JaoDekeyser/Linefollower/readme.md

# LineFollower

Voor iedereen die een RC auto'tje wilt dat je niet hoeft/kan besturen.

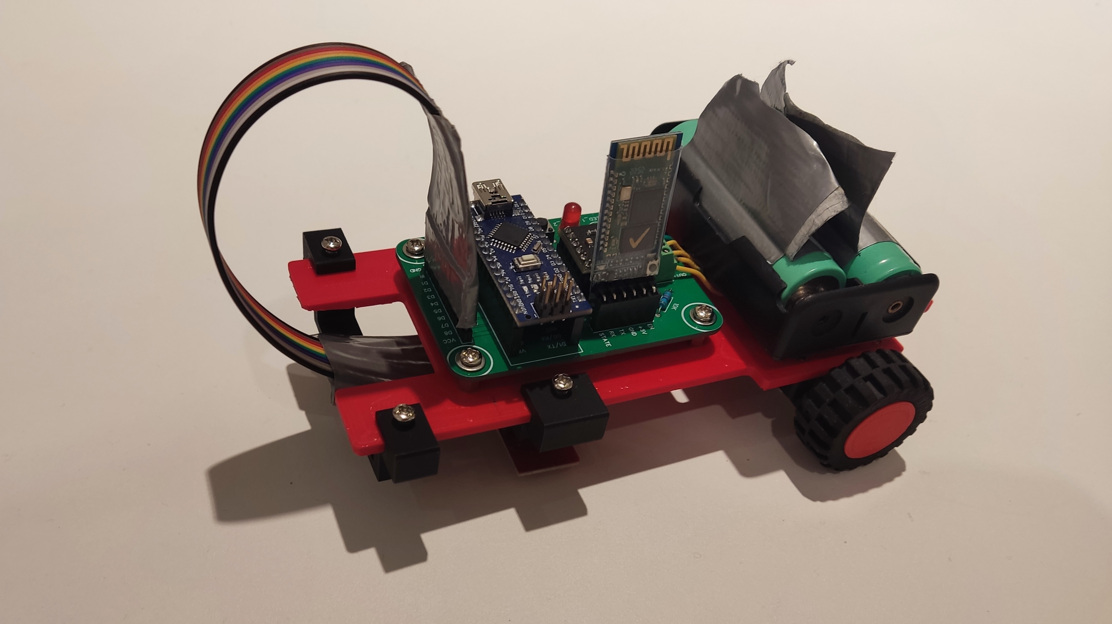
[picture p1: images/Line_Follow_Robot.jpg]
Line follow robot Syntheseproject Jao


## specifications

microcontroller: Arduino Nano Every ATMEGA4809 AVR

motors: 6V Pololu micro metal gearmotors with gear ratio30:1

h-bridge: DRV8833 Dual H-Bridge Motor Drive

sensors: QTR-8A Reflectance Sensor

batteries: 18650 Li-ion

wireless communication: HC-05 -Bluetooth to Serial Port Module

distance sensor - motors: +-8cm

weight: 283g

speed: 0.6 m/s
