JaoDekeyser/Linefollower/code/proof of concepts/wireless communication/readme.md

# draadloze communicatie proof of concept
minimale hard- en software waarmee aangetoond wordt dat duplex kan gecommuniceerd worden tussen de microcontroller en een smartphone, gebruik makend van Serial Bluetooth terminal
<br />
### configuratie
HC05-Bluetooth to Serial Port Module
### opmerkingen
PC arduino serial monitor & smartphone nodig
### gebruiksaanwijzing
Aangeraden smartphone APP: Serial Bluetooth Terminal
