JaoDekeyser/Linefollower/bill of materials/readme.md

## bill of materials
<br />

|volgnummer|naam|omschrijving|nieuw/recup|kostprijs/stuk|aantal|subtotaal|
|---|----|---|---|---|---|---|
| 1| Microcontroller |  Arduino Nano Every ATMEGA4809 AVR |nieuw| 14.96€ | 1 | 14.96€ |
| 2| Sensor |  QTR-8A Reflectance Sensor Array  |nieuw| 1.24€ | 1 | 1.24€ |
| 3| H-brug |  DRV8833 Dual H-Bridge Motor Drive  |nieuw| 0.48€ | 1 | 0.48€ |
| 4| Motor |  Gear motor 6V 50:1 (GA12-N20 --> chinees)  |nieuw| 1.75€ | 2 | 3.50€ |
| 5| Bluetooth module |  HC-05 -Bluetooth to Serial Port Module  |nieuw| 3.47€ | 1 | 3.90€ |
| 6| Batterij |  18650 Li-ion  |nieuw| 2.51€ | 2 | 5.02€ |
| 7| Batterij-houder |  18650 batterij-houder  |nieuw| 1.64€ | 1 | 1.64€ |
| 8| Batterij-lader |  18650 batterij-lader  |nieuw| 3.69€ | 1 | 3.69€ |
| 9| Weerstand 220Ω |  Arduino 220Ω resistor  |recup| 0.00€ | 1 | 0.00€ |
| 10| Weerstand 10kΩ |  Arduino 10kΩ resistor  |recup| 0.00€ | 1 | 0.00€ |
| 11| LED |  Arduino LED blauw  |recup| 0.00€ | 1 | 0.00€ |
| 12| Drukknop |  Arduino tactile switch  |recup| 0.00€ | 1 | 0.00€ |
| 13| Aan-uit knop |  rocker switch  |nieuw| 0.83€ | 1 | 0.83€ |
| 14| PCB |  JLC-PCB printplaat  |nieuw| 1.34€ | 1 | 1.34€ |
| 15| Aansluiting voeding |  2 Pin Schroef Terminal Block Connector 2.54mm Afstand  |nieuw| 0.30€ | 1 | 0.30€ |
| 16| Aansluiting motoren |  4 Pin Schroef Terminal Block Connector 2.54mm Afstand  |nieuw| 0.45€ | 1 | 0.45€ |
| 17| Header pins (male: M) |  2x6, 2x11, 2x15 (vrije keuze) |recup|  0.00€ | 6 | 0.00€ |
| 18| Header connectors (female: V) |  3x6, 2x15 (vrije keuze)  |recup| 0.00€ | 5 | 0.00€ |
| 19| Bout + Moer set |  M3x16mm  |nieuw| 4.00€/30stks | 10 | 0.80€ |
| 20| Dupont kabels |  M-M, M-V, V-V  |recup| 0.00€ | véél | 0.00€ |
| 21| Band |  Lego-auto wiel  |recup| 0.00€ | 2 | 0.00€ |
| 22| Wiel |  3D-print  |nieuw| 0.10€ | 2 | 0.10€ |
| 23| Motor-houder |  3D-print  |nieuw| 0.10€ | 2 | 0.10€ |
| 24| Chasis |  3D-print  |recup| 0.00€ | 1 | 3.75€ |
| 25| Viltglijder |  Vilten meubeldoppen  |nieuw| 0.05€ | 1 | 0.05€ |
| Totaal |  | || | # = 48+draadjes | 42.10€ |
