JaoDekeyser/Linefollower/code/proof of concepts/interrupt/Interrupt Jao.pdf

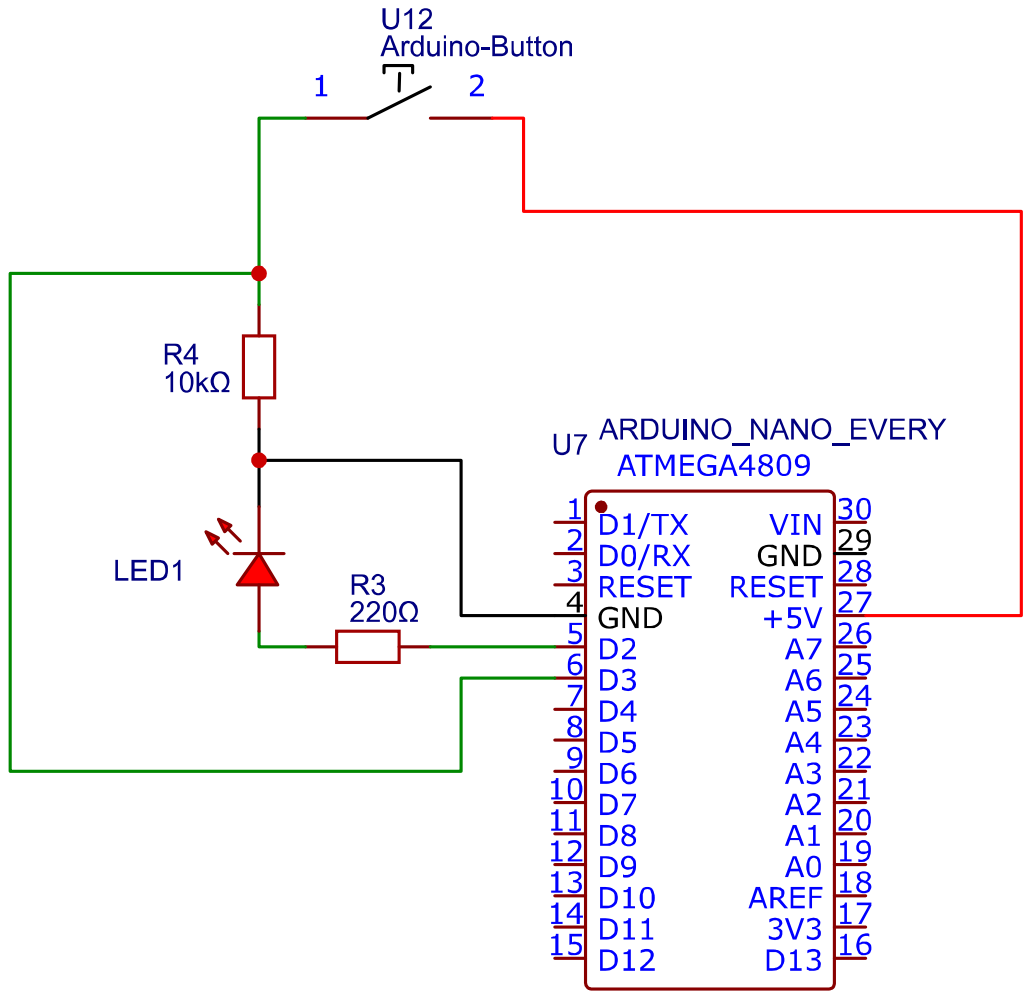
[picture p3: page 1]
