JaoDekeyser/Linefollower/code/proof of concepts/wireless communication/Draadloze communicatie.pdf

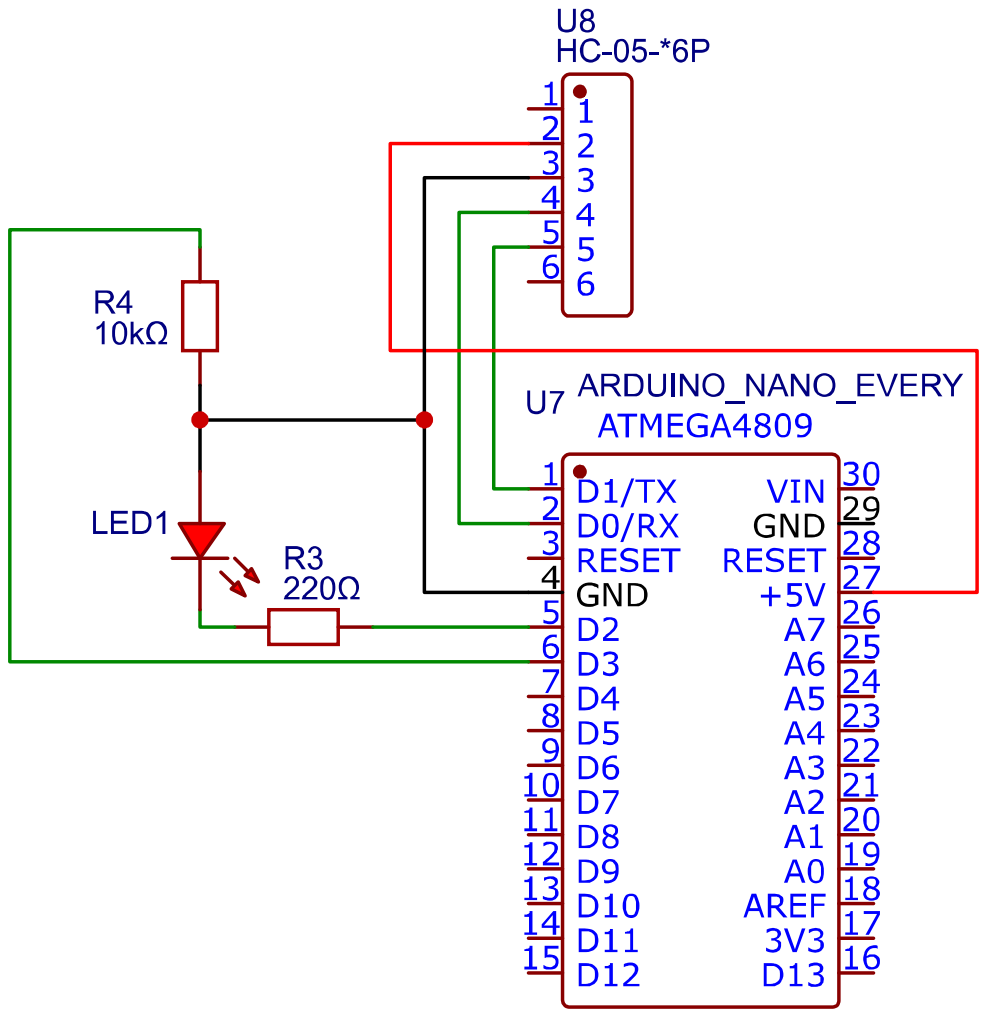
[picture p4: page 1]
