JaoDekeyser/Linefollower/code/proof of concepts/hbridge/PoC H-brug Jao.pdf

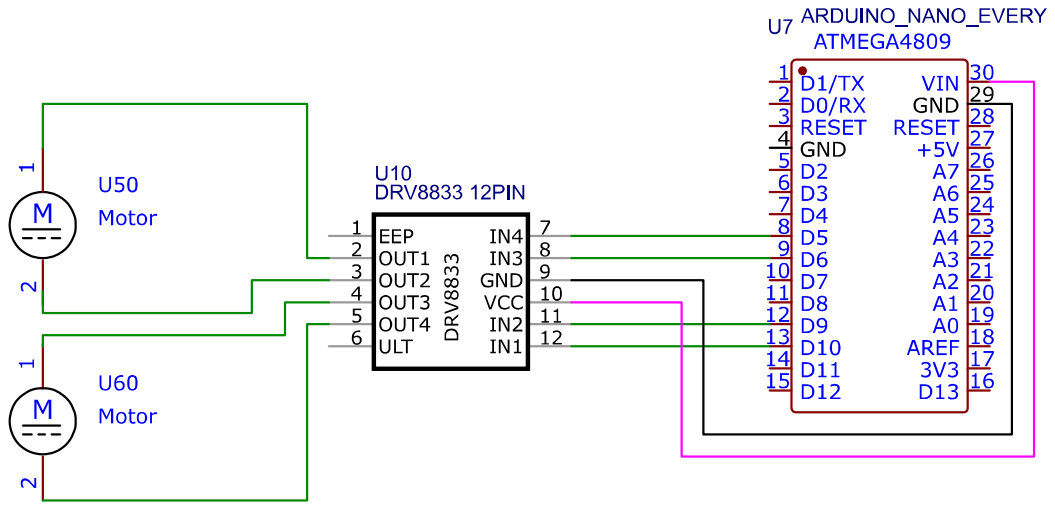
[picture p5: page 1]
