JaoDekeyser/Linefollower/code/proof of concepts/sensor/PoC Sensor.pdf

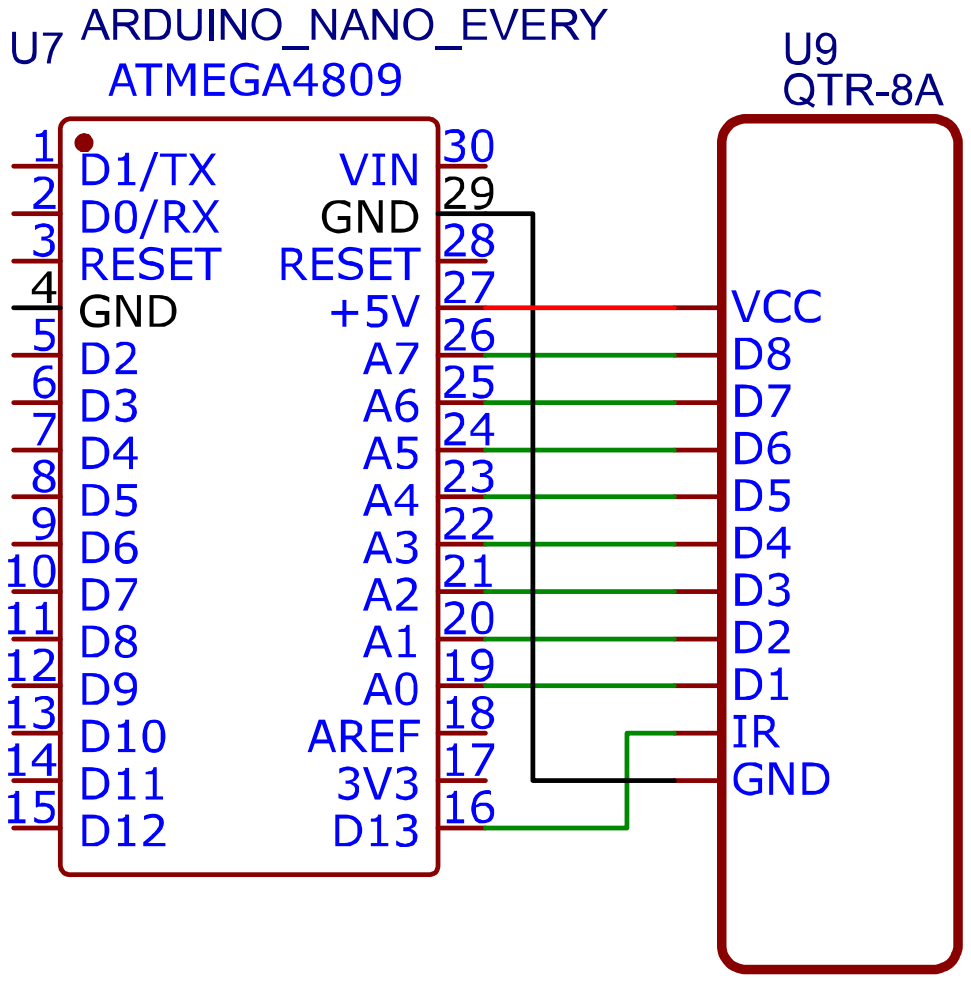
[picture p6: page 1]
