JaoDekeyser/Linefollower/technische tekeningen/elektronisch/Aansluitschema Jao.pdf

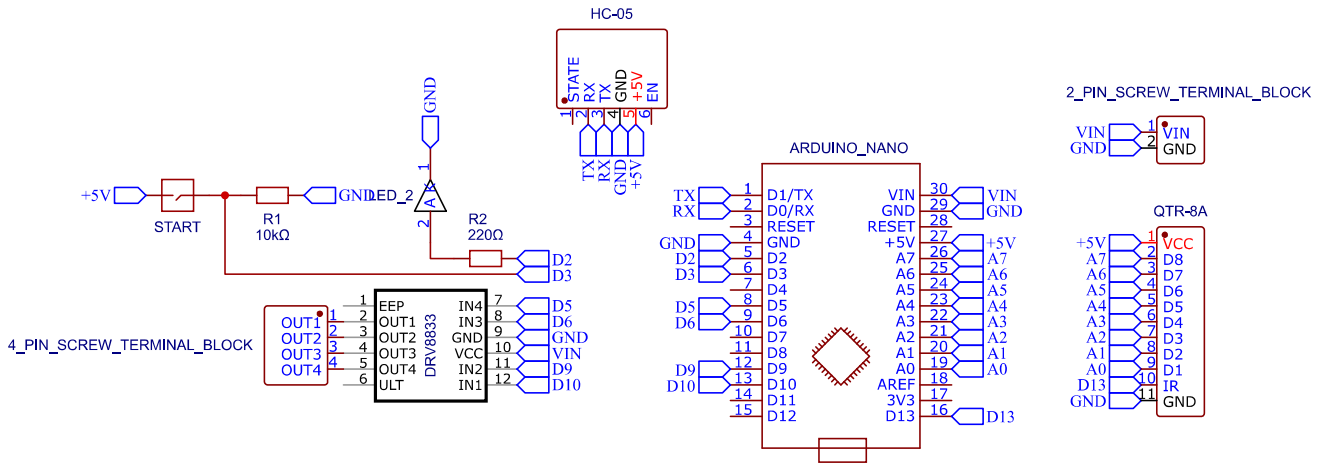
[picture p7: page 1]
