JaoDekeyser/Linefollower/technische tekeningen/elektronisch/Elektrisch schema Jao.pdf

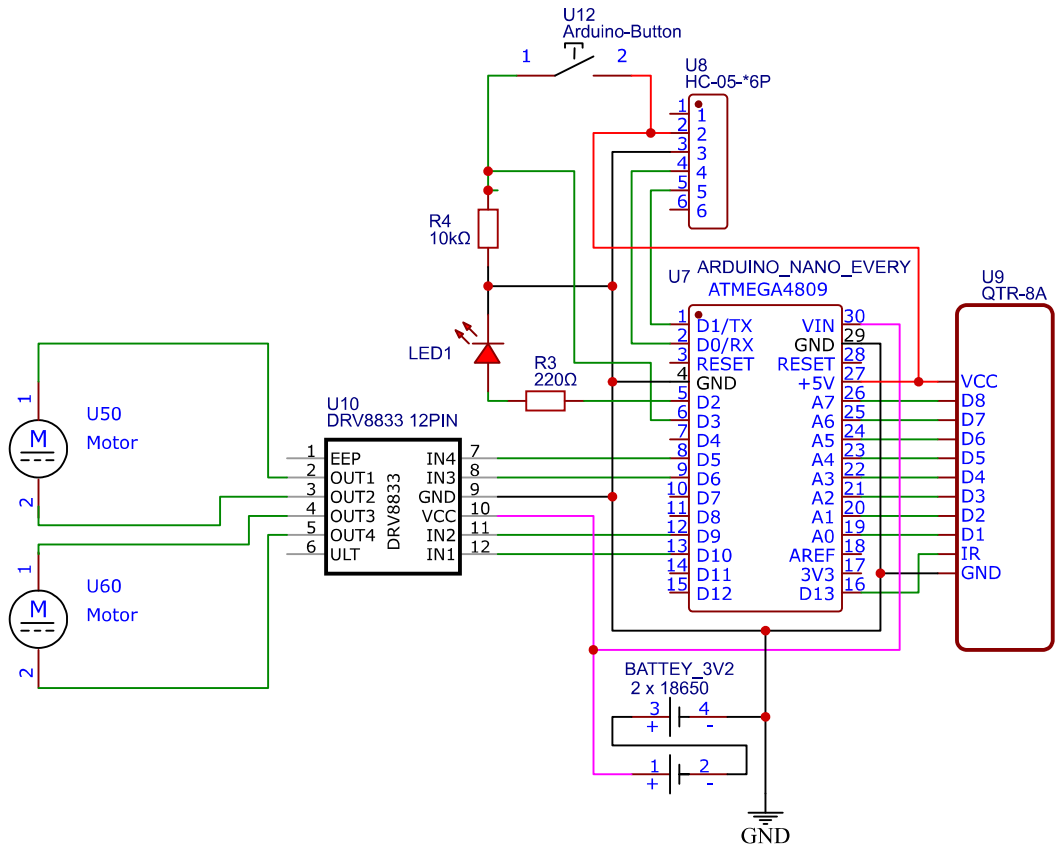
[picture p8: page 1]
