JaoDekeyser/Linefollower/(list of files, drawings)

Other design files:
code/proof of concepts/hbridge/SCH_H-brug_Jao.json
code/proof of concepts/interrupt/SCH_PoC Interrupt Jao.json
code/proof of concepts/sensor/SCH_PoC Sensor_Jao.json
code/proof of concepts/wireless communication/SCH_PoC draadloze communicatie Jao.json
technische tekeningen/elektronisch/SCH_Aansluitschema Jao_2023-12-15.json
technische tekeningen/elektronisch/SCH_Line Follower Robot_Jao.json
